Le-Bobby-Cow/MESA_Arduino_Project_-_Water_Tester/Documentation/Work-Progression Log.md

# Prototyping Log

Format :

## Prototype X
### Build Process
- Note any issues that arose during the build process

### Programming Process
- Note any issues or features that were added or resolved

### Prototype Performance Report
- Describe the performance and functionality
- Include Annotated Pictures

### Issues and Additions
- Note any issues that arose during testing
- Note future additions for the next prototype
