Le-Bobby-Cow/MESA_Arduino_Project_-_Water_Tester/Documentation/Design Brief.md

# Design Brief
Objective: The Design Brief provides a brief, non-technical overview of the entire project. The
design brief is a short document that can be used alone or as support during the presentations and
poster symposium to provide the reader with enough information about the project to:
- understand the target user and the challenges they face that inspired the project;
- state the project goals;
- provide a general idea of the prototype and its key features;
- relay the current status of the project;
- convey the expected impact for the user and how perceived inequities are relieved;
- reflect on the team’s experience implementing the Human Centered Design Process.

## Format: Teams must use the Design Brief Template (see Appendix).

Required Elements
1. Problem Statement: Describe the people who will benefit from the project and the challenges
they face. Discuss the issues of inequity that the project hopes to address. 100 word maximum
2. User Research: Discuss key information about the users gathered through your research,
interviews, and ongoing discussion with the user throughout the project. The information
shared here should be directly related to the user’s needs, insight, goals, and prototype. 200
word maximum
3. User Insight: Discuss your team’s understanding of the experiences, emotions, and motivations
of the users. This insight should inform the rest of the project and help the reader have a deeper
understanding of the inequity of the user. 200 word maximum
4. User Needs: Develop a specific list of the user’s needs produced from the user insight. The
needs should be reflected in the project goals. 100 word maximum
5. Project Goals: List project goals and describe how they are linked to and will adequately meet
the user’s needs and address inequities and/or barriers faced by the user. Meeting these goals
should be reflected in the key features and graphic(s) provided. 100 word maximum
6. Key Features of Design: List key features, illustrating that the design will adequately meet
project goals. 200 word maximum
7. Prototype Graphic: Include a graphic that is easy to understand with key features that are
adequately labeled. The reader should have a general understanding of how the prototype
functions by looking at the graphic.
8. Status of Project: Describe the current status of the project and discuss potential next steps. 200
word maximum
9. Impact: Discuss how design addresses inequities for the user and/or removes barriers. This
impact should reflect how the team met the project goals. 200 word maximum
10. Reflection: Show that the team has an increased understanding of human-centered design.
Examples of personal growth and insights gained about designing for others and helping them
overcome challenges should also be included. 200 word maximum
