Le-Bobby-Cow/MESA_Arduino_Project_-_Water_Tester/Design/Electrical Schematics/Prototype Schematic rev.2.png

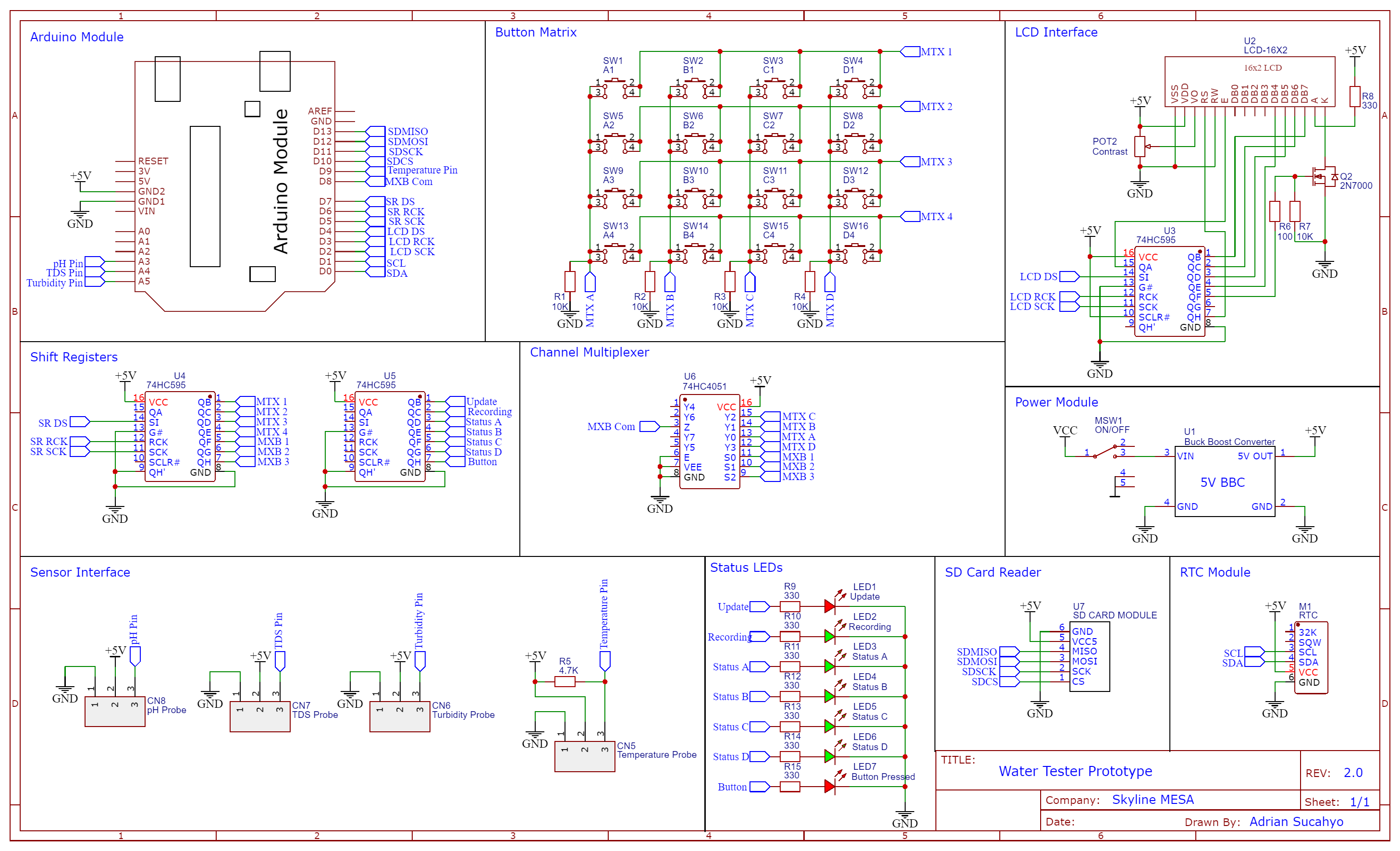
Design/Electrical Schematics/Prototype Schematic rev.2.png
