Le-Bobby-Cow/MESA_Arduino_Project_-_Water_Tester/Documentation/Finalized Documentation/Arduino MESA Water Filter Perspective.png

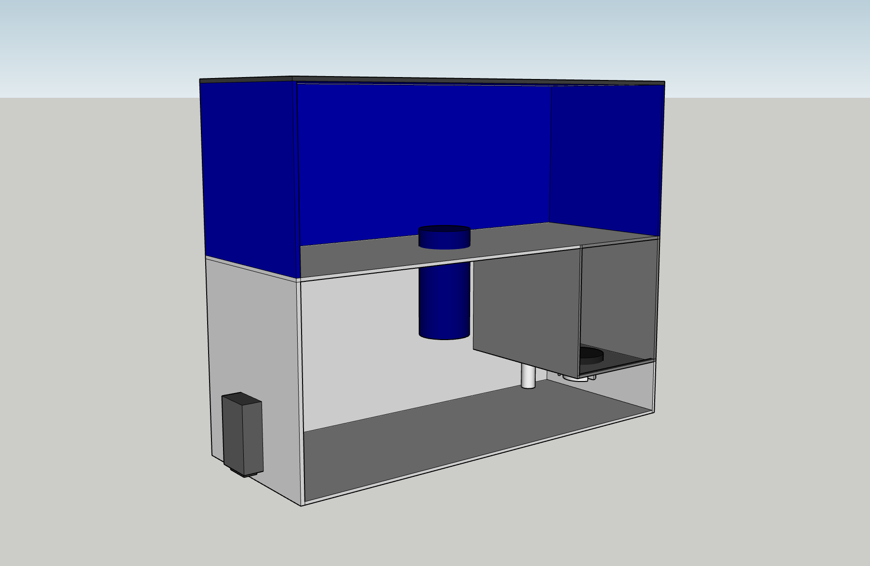
Documentation/Finalized Documentation/Arduino MESA Water Filter Perspective.png
