Le-Bobby-Cow/MESA_Arduino_Project_-_Water_Tester/Documentation/Finalized Documentation/Arduino MESA Water Filter Side.png

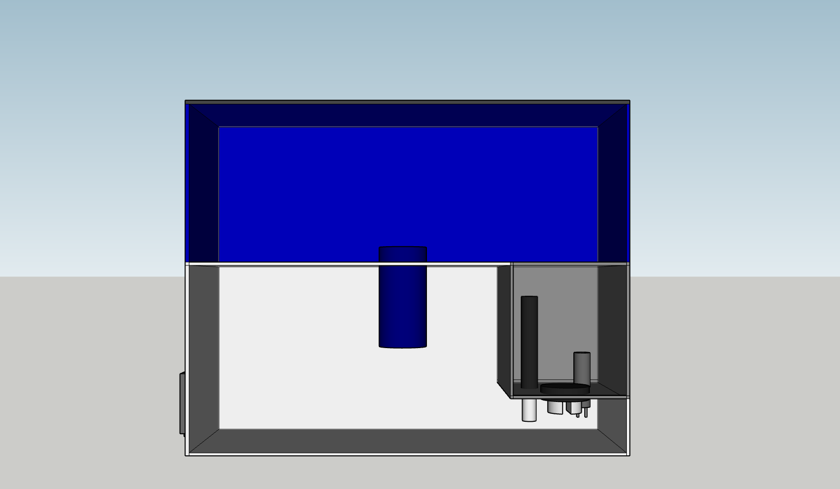
Documentation/Finalized Documentation/Arduino MESA Water Filter Side.png
