Le-Bobby-Cow/MESA_Arduino_Project_-_Water_Tester/MESA_Sterling_Scholar/MESA_Sterling_Scholar/data/blue-long-exposure-photo-of-body-of-water-lake-lake-image.jpeg

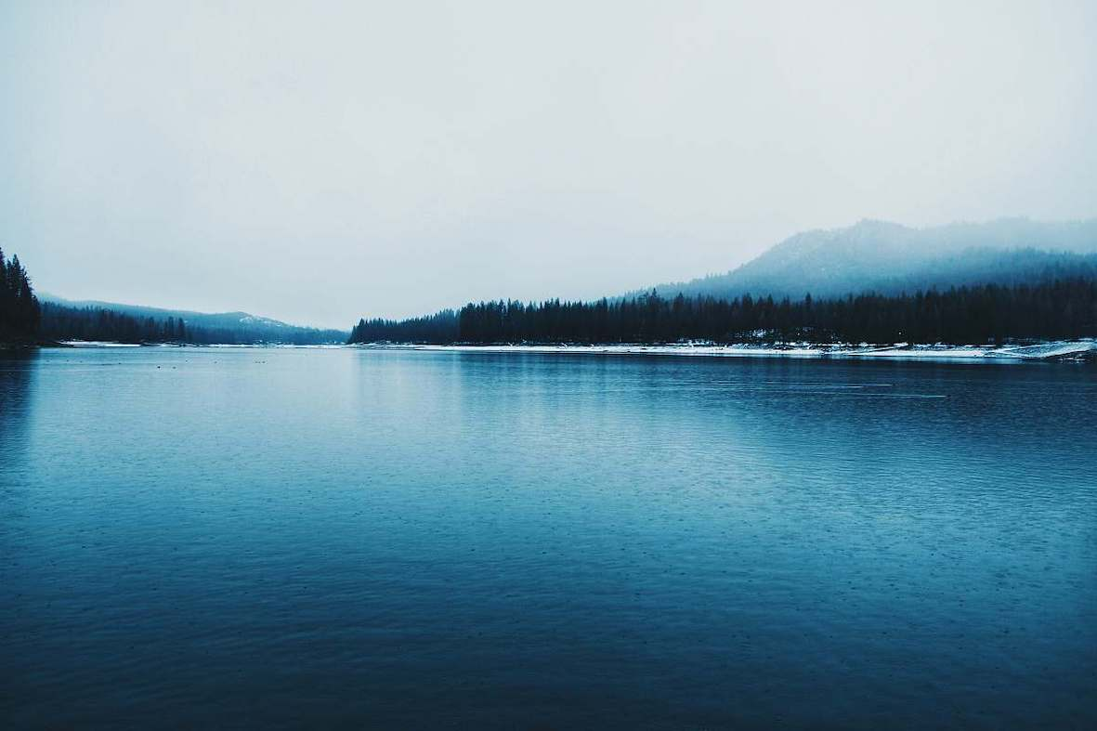
MESA_Sterling_Scholar/MESA_Sterling_Scholar/data/blue-long-exposure-photo-of-body-of-water-lake-lake-image.jpeg
