Le-Bobby-Cow/MESA_Arduino_Project_-_Water_Tester/Design/Wiring Diagrams/BOM rev.3.png

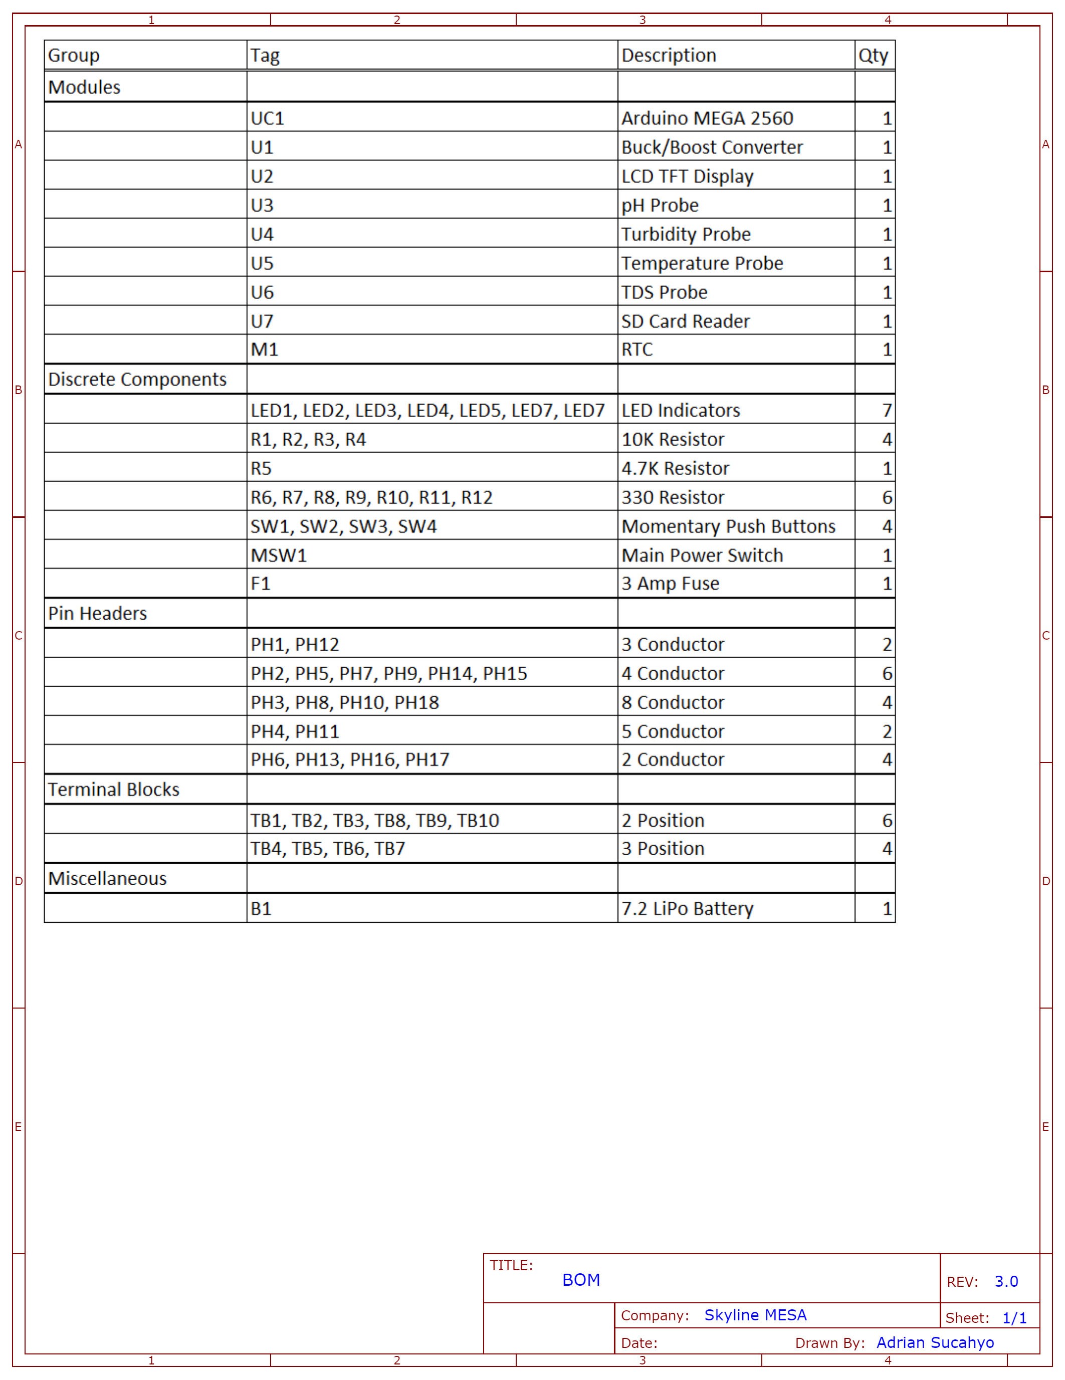
Design/Wiring Diagrams/BOM rev.3.png
