Le-Bobby-Cow/MESA_Arduino_Project_-_Water_Tester/Design/Wiring Diagrams/Cover Page rev.3.png

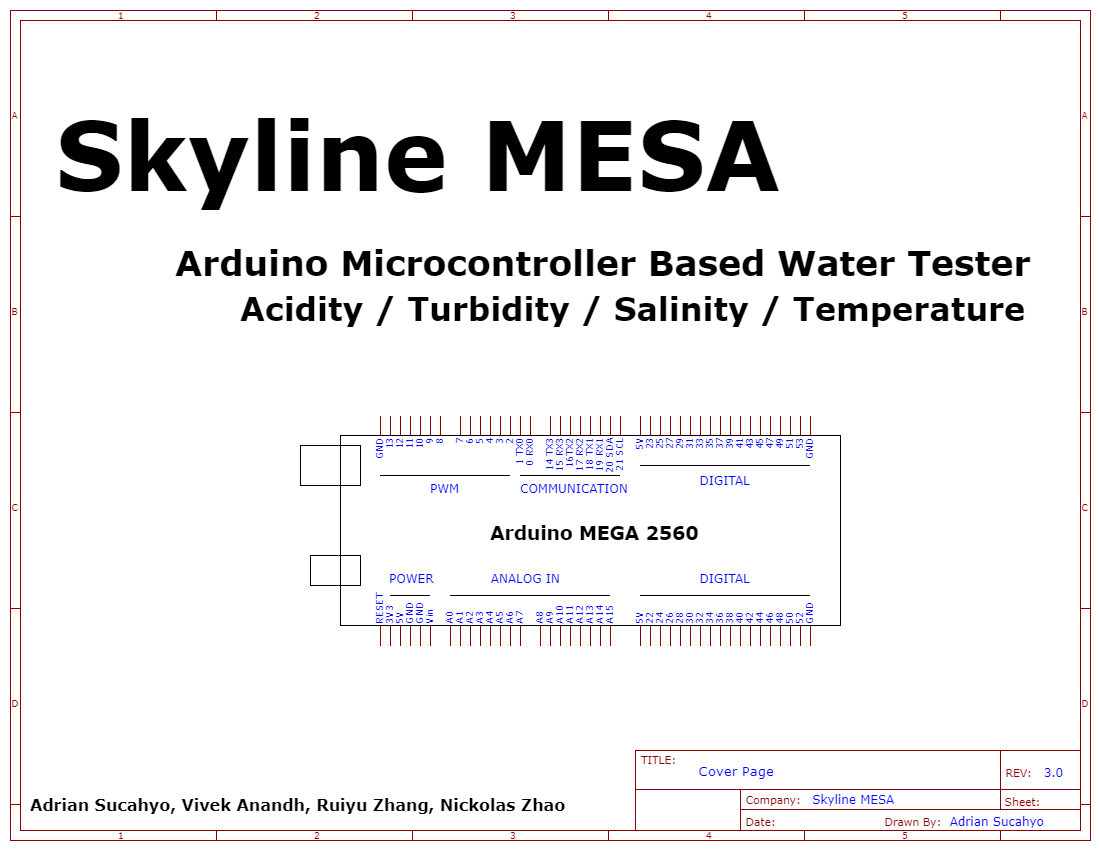
Design/Wiring Diagrams/Cover Page rev.3.png
