Le-Bobby-Cow/MESA_Arduino_Project_-_Water_Tester/Design/Wiring Diagrams/Wiring Design Reference rev.3.png

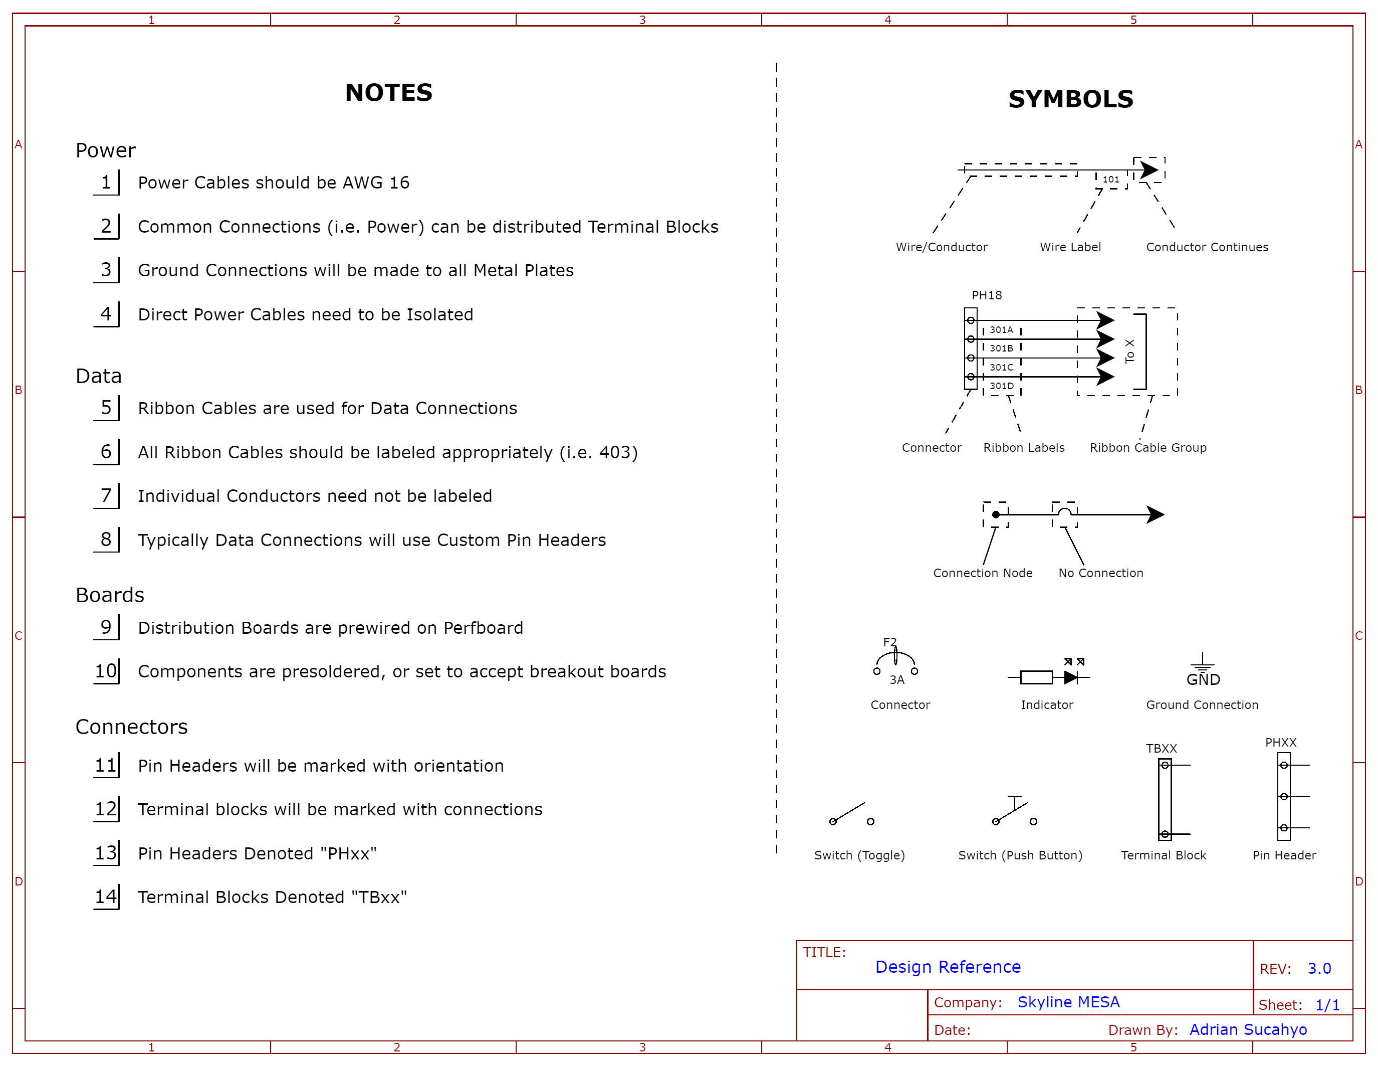
Design/Wiring Diagrams/Wiring Design Reference rev.3.png
