Le-Bobby-Cow/MESA_Arduino_Project_-_Water_Tester/Design/Block Diagrams/Water Tester Block Diagram rev.2.png

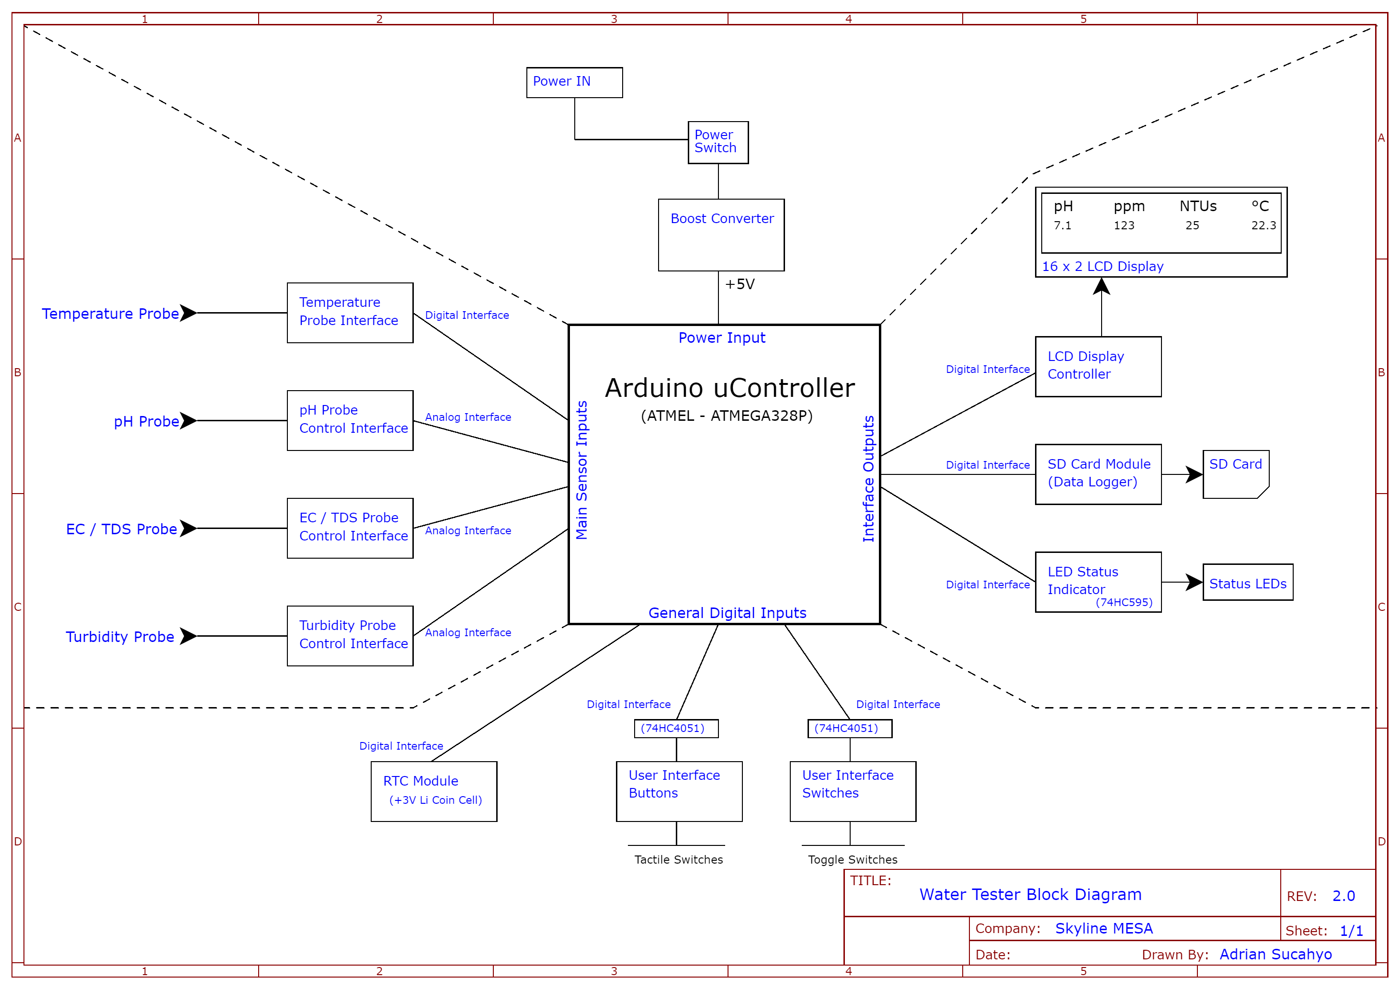
Design/Block Diagrams/Water Tester Block Diagram rev.2.png
