Le-Bobby-Cow/MESA_Arduino_Project_-_Water_Tester/Documentation/Finalized Documentation/MESA Water Tester (Filter).pdf

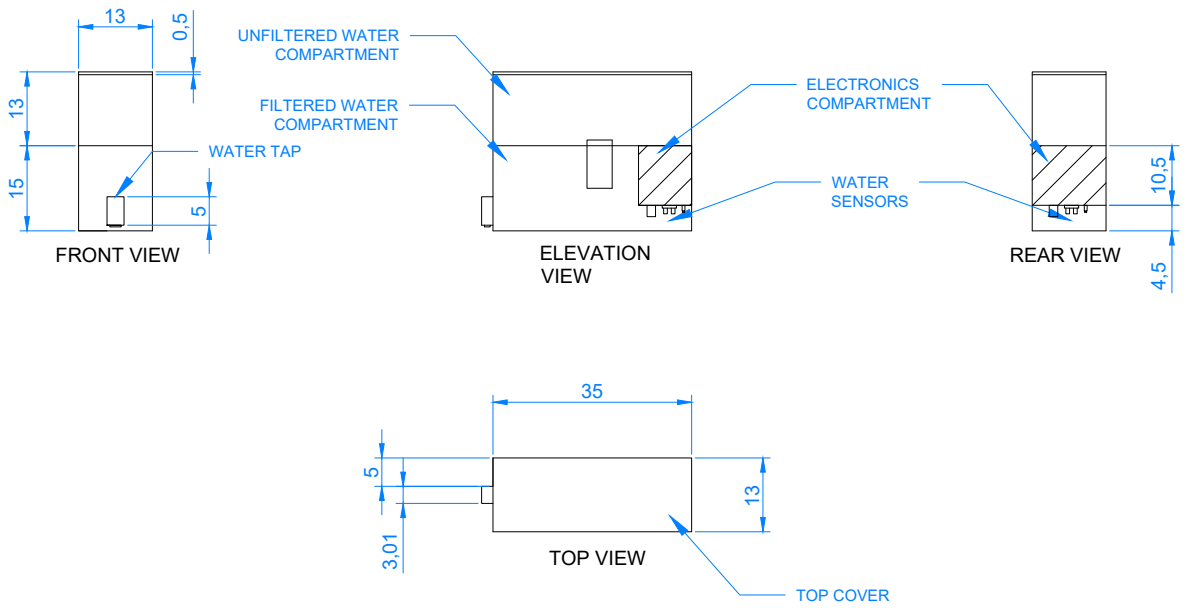
[picture p17: page 1]
TOP VIEW ELEVATION VIEW FRONT VIEW; REAR VIEW

3,01 5 WATER TAP ELECTRONICS COMPARTMENT TOP COVER WATER SENSORS UNFILTERED WATER COMPARTMENT FILTERED WATER COMPARTMENT
