Le-Bobby-Cow/MESA_Arduino_Project_-_Water_Tester/Design/Wiring Diagrams/All Wiring Diagrams rev.3.pdf

## Power Regulator

+5V

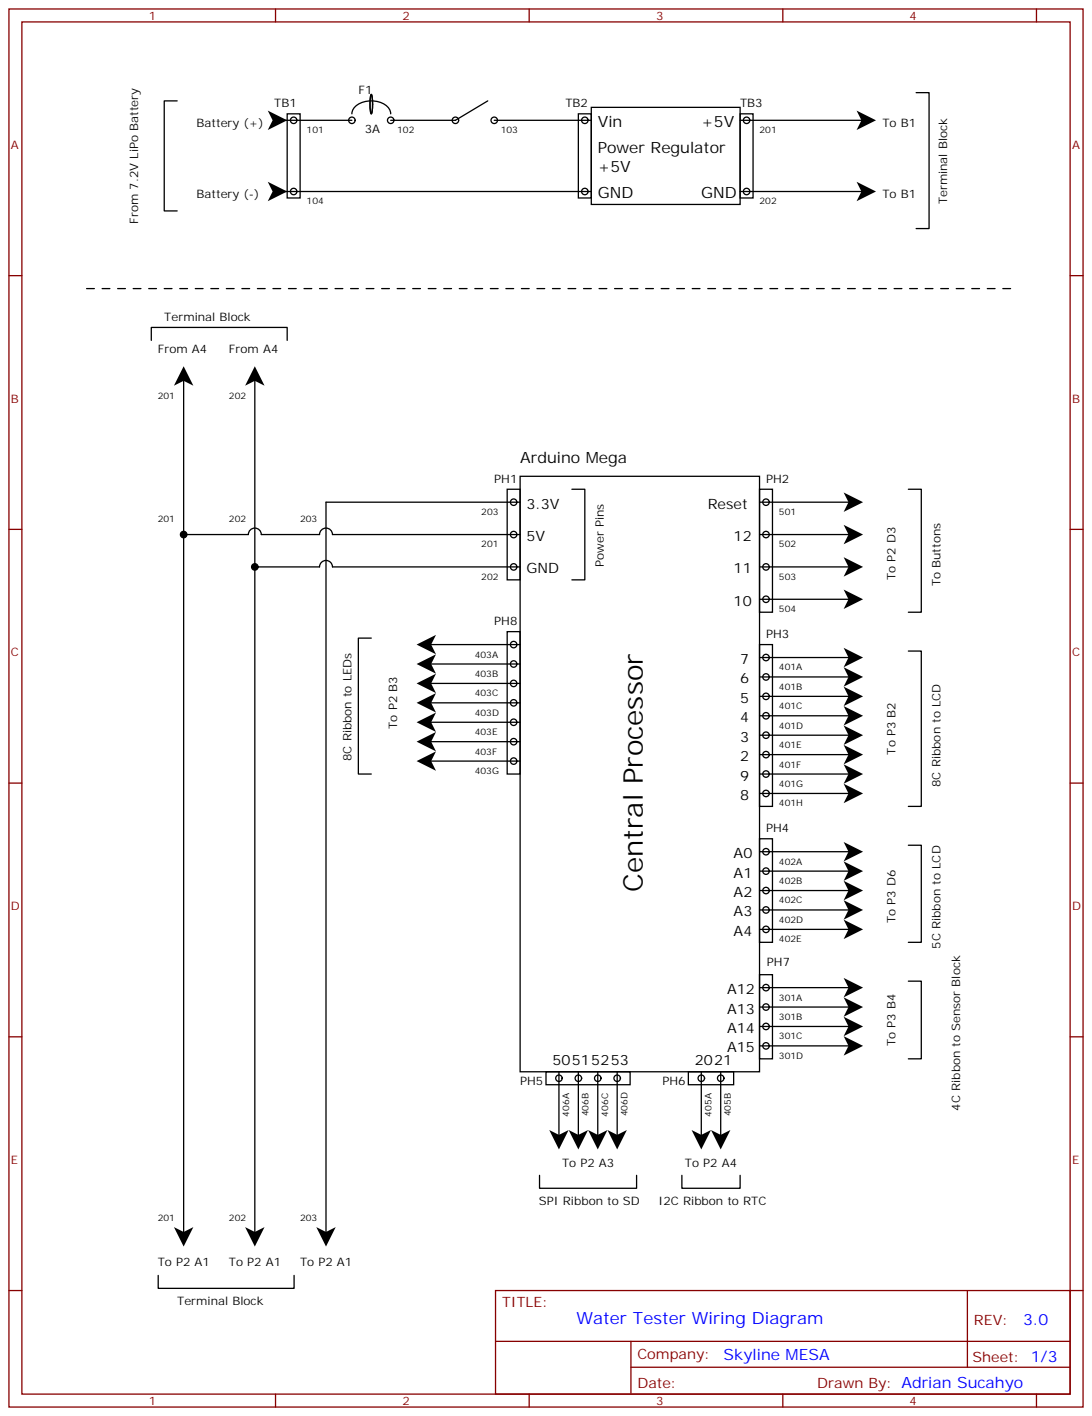
[picture p18: page 1]

8C Ribbon to LCD 5C Ribbon to LCD

4C Ribbon to Sensor Block

Drawn By: Adrian Sucahyo

## Power Regulator

+5V

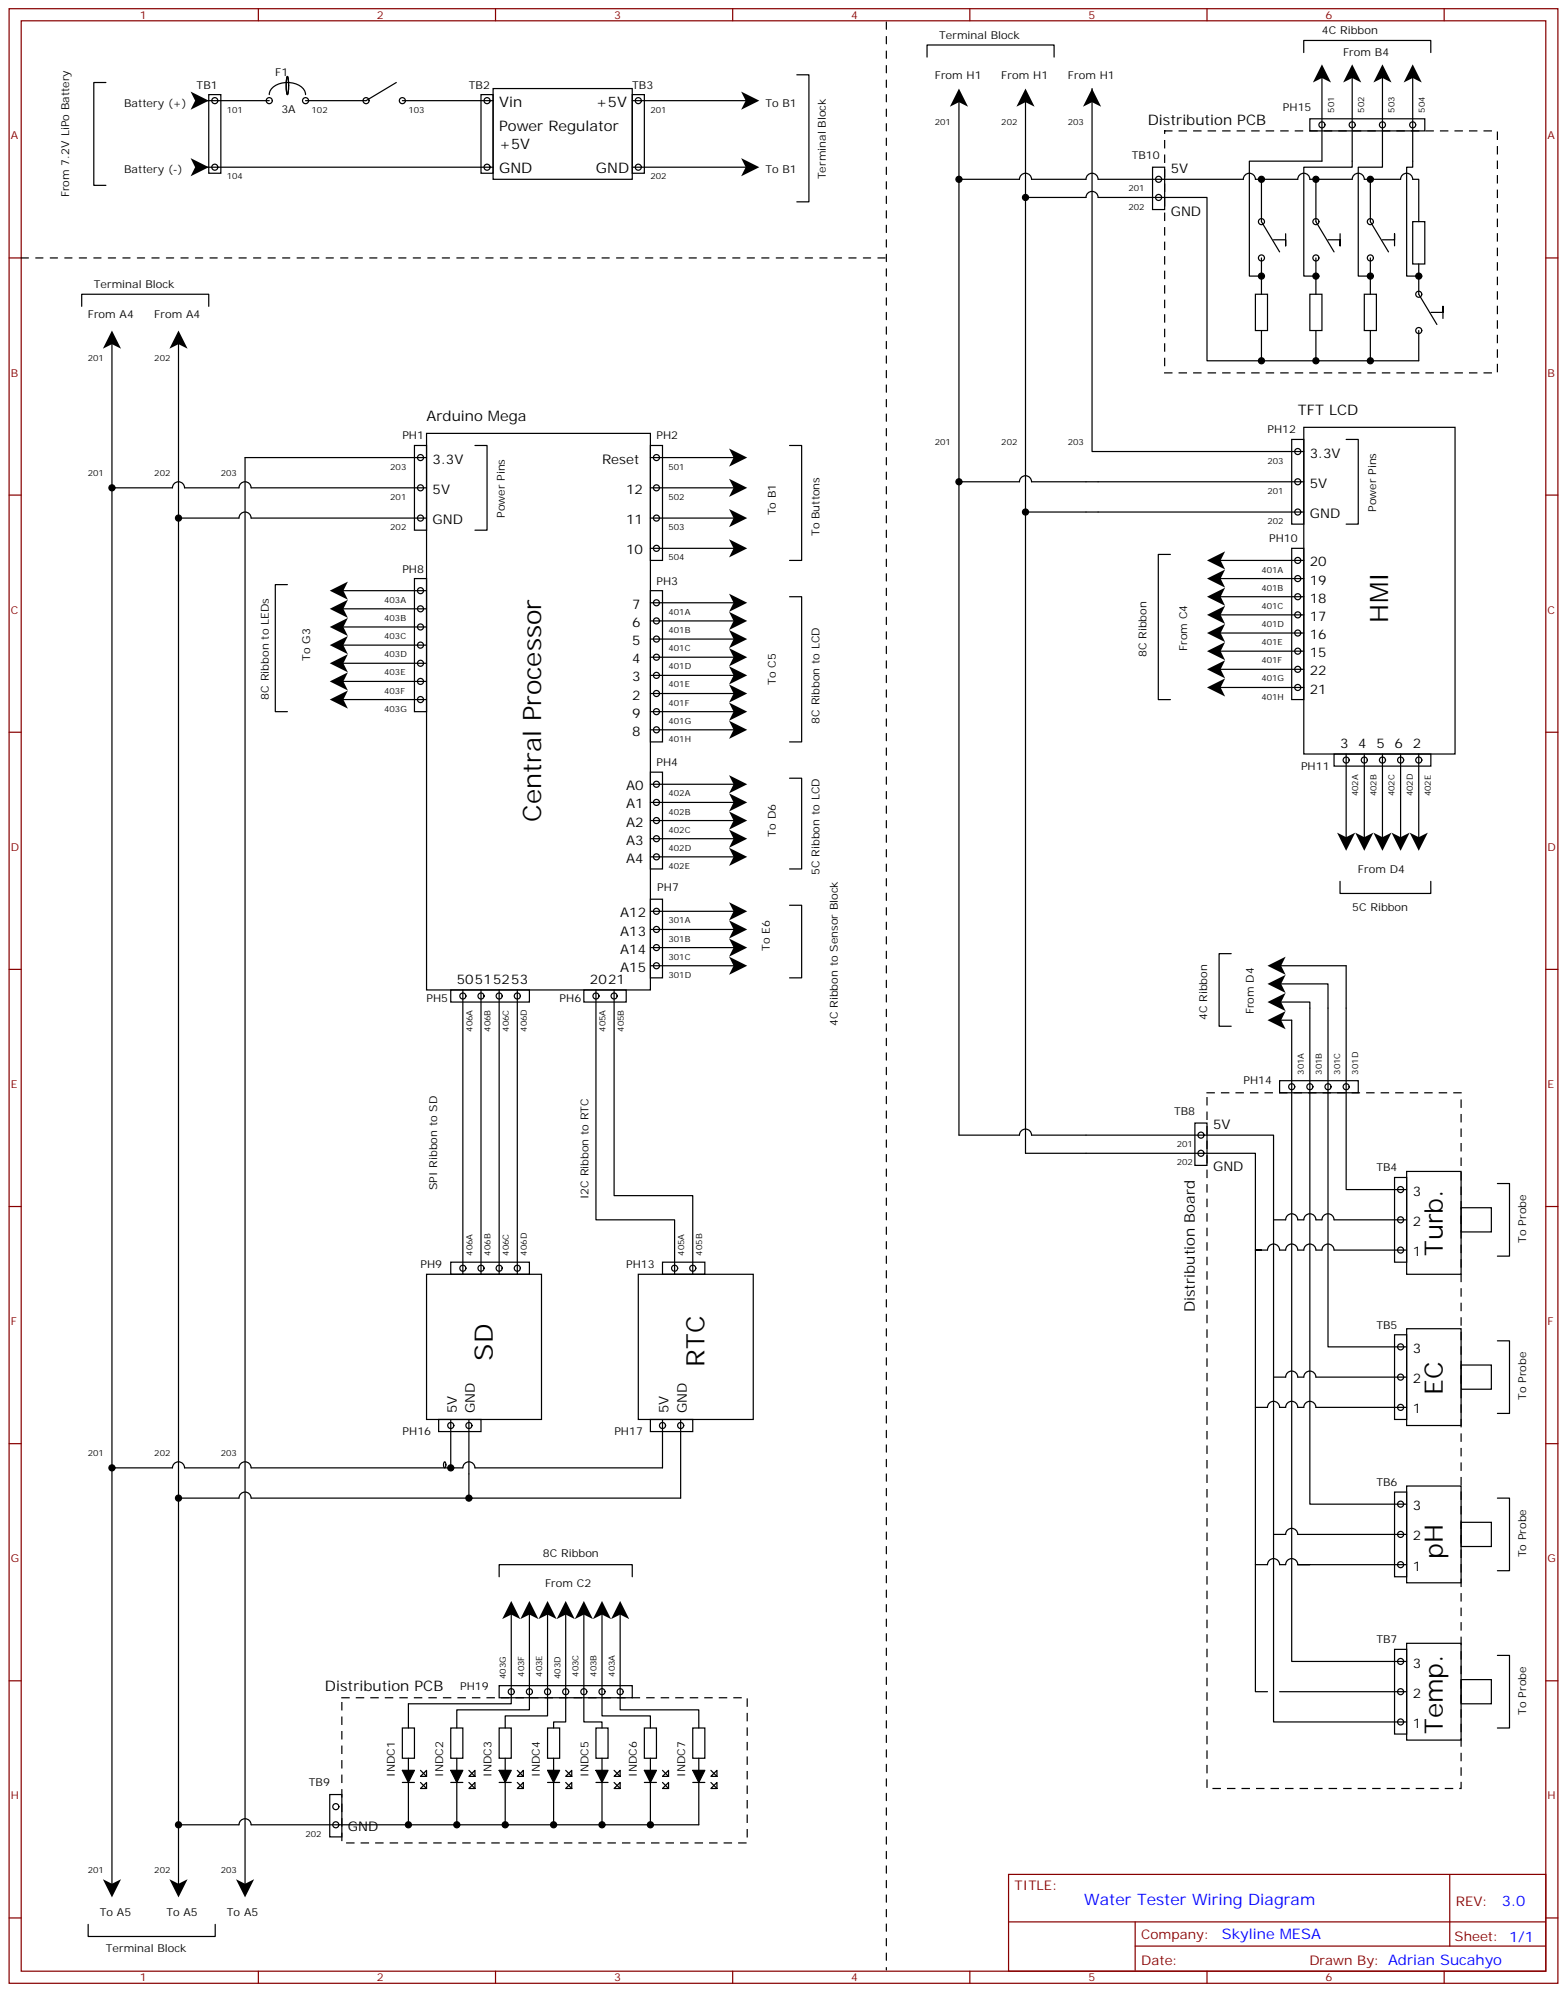
[picture p19: page 2]

8C Ribbon to LCD 5C Ribbon to LCD

4C Ribbon to Sensor Block

SPI Ribbon to SD

pH Temp. EC Turb.

To Probe To Probe

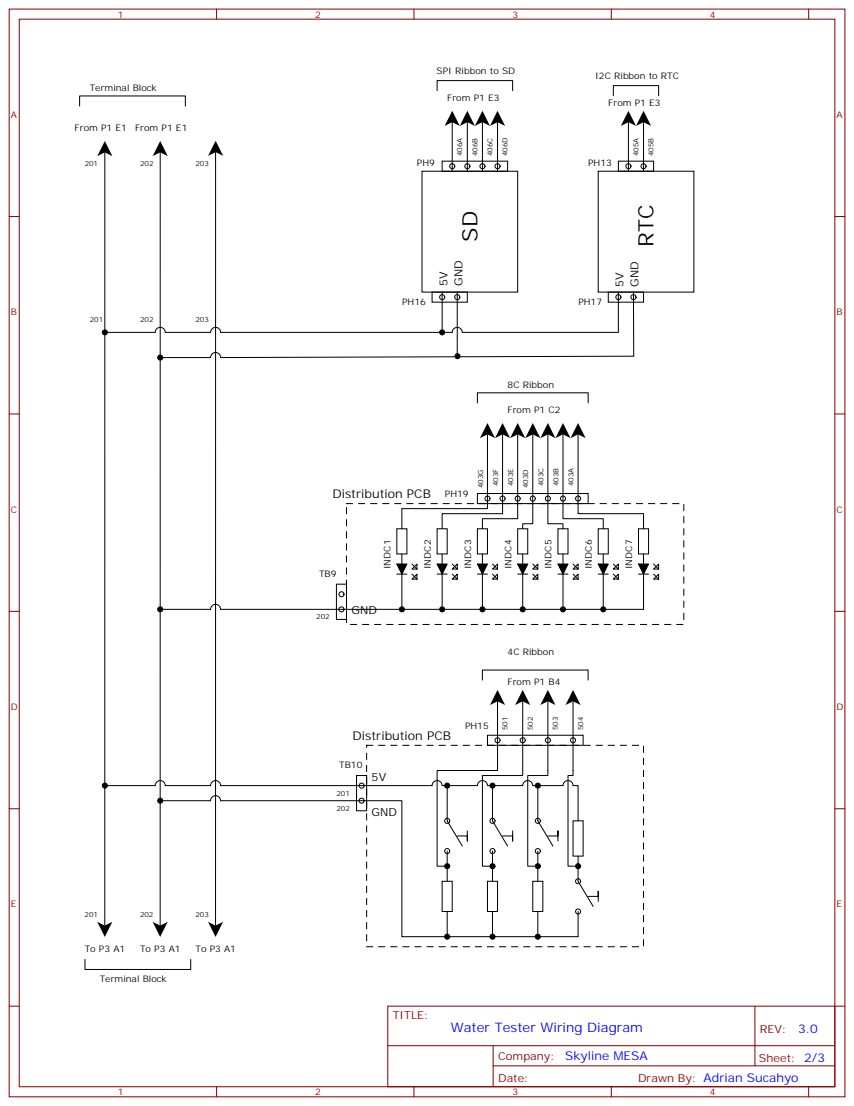
[picture p20: page 3]

I2C Ribbon to RTC SPI Ribbon to SD

## TFT LCD

# 4C Ribbon 301A

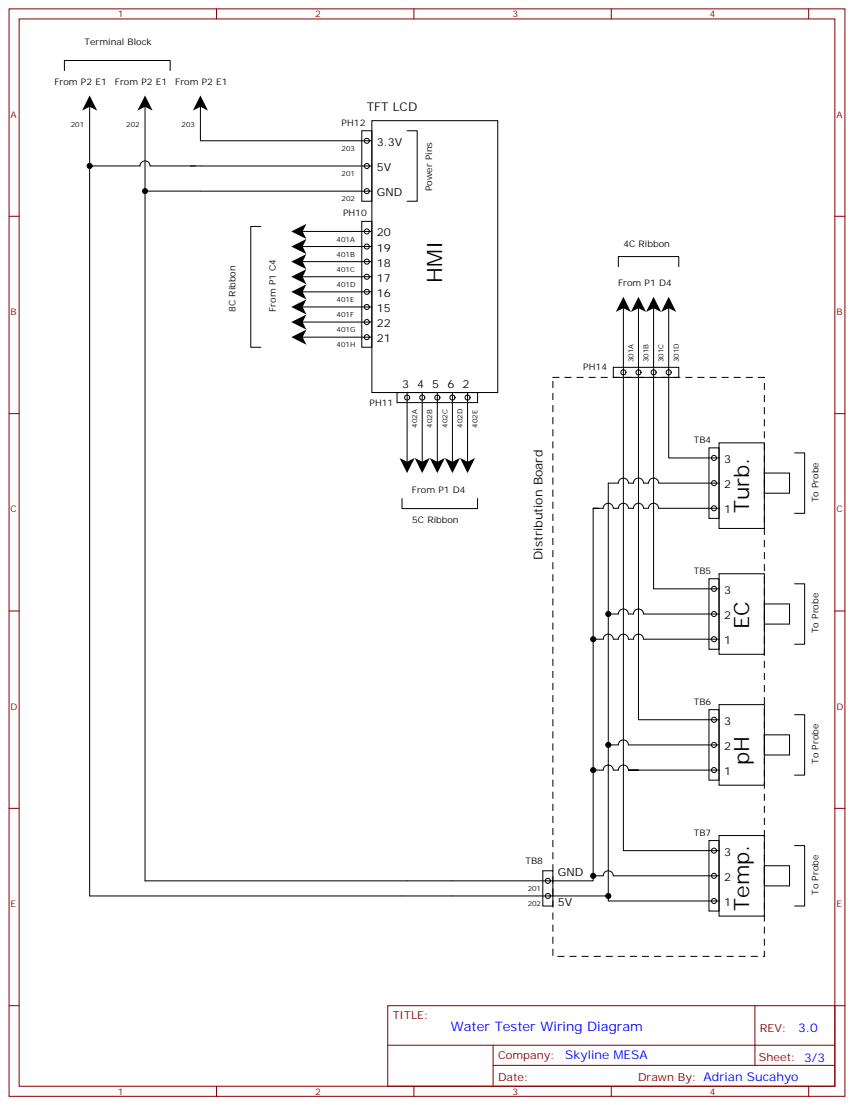
[picture p21: page 4]

pH Temp. EC Turb.

To Probe To Probe
