Le-Bobby-Cow/MESA_Arduino_Project_-_Water_Tester/Design/Wiring Diagrams/Wiring Diagram rev.3.pdf

A | A
B | B

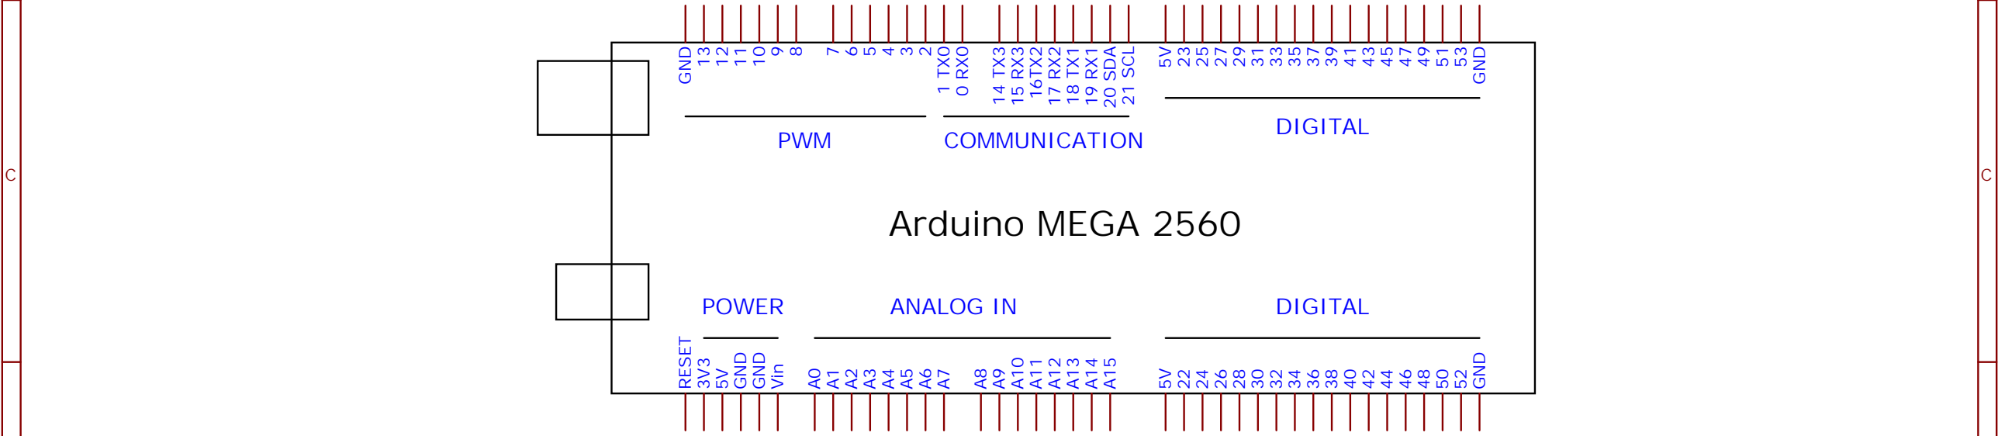
[picture p22: figure]
Arduino MEGA 2560; 53 GND; GND; 19 RX1 20 SDA 21 SCL; GND RESET; GND Vin; POWER; ANALOG IN; PWM; COMMUNICATION; DIGITAL

D | D

### TITLE:

Cover Page | REV: 3.0

### Date:

### Sheet:

## Drawn By: Adrian Sucahyo

## Company: Skyline MESA

# Skyline MESA

# Arduino Microcontroller Based Water Tester

# Acidity / Turbidity / Salinity / Temperature

# Adrian Sucahyo, Vivek Anandh, Ruiyu Zhang, Nickolas Zhao

## Power Cables should be AWG 16

## Common Connections (i.e. Power) can be distributed Terminal Blocks

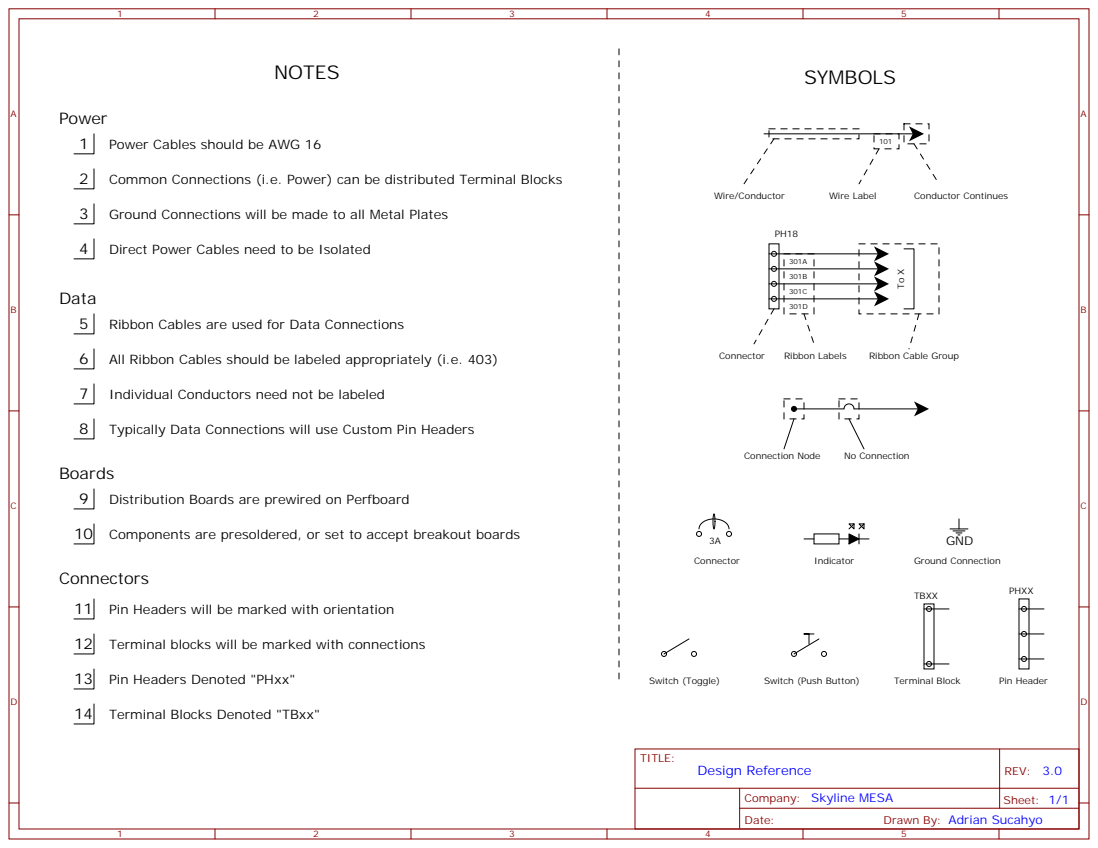
[picture p23: page 2]

3 Ground Connections will be made to all Metal Plates

4 Direct Power Cables need to be Isolated

Data
Ribbon Cables are used for Data Connections
All Ribbon Cables should be labeled appropriately (i.e. 403)
Individual Conductors need not be labeled

8 Typically Data Connections will use Custom Pin Headers

Boards
9 Distribution Boards are prewired on Perfboard

10 Components are presoldered, or set to accept breakout boards

11 Pin Headers will be marked with orientation

12 Terminal blocks will be marked with connections

13 Pin Headers Denoted "PHxx"

14 Terminal Blocks Denoted "TBxx"

## Power Regulator

+5V

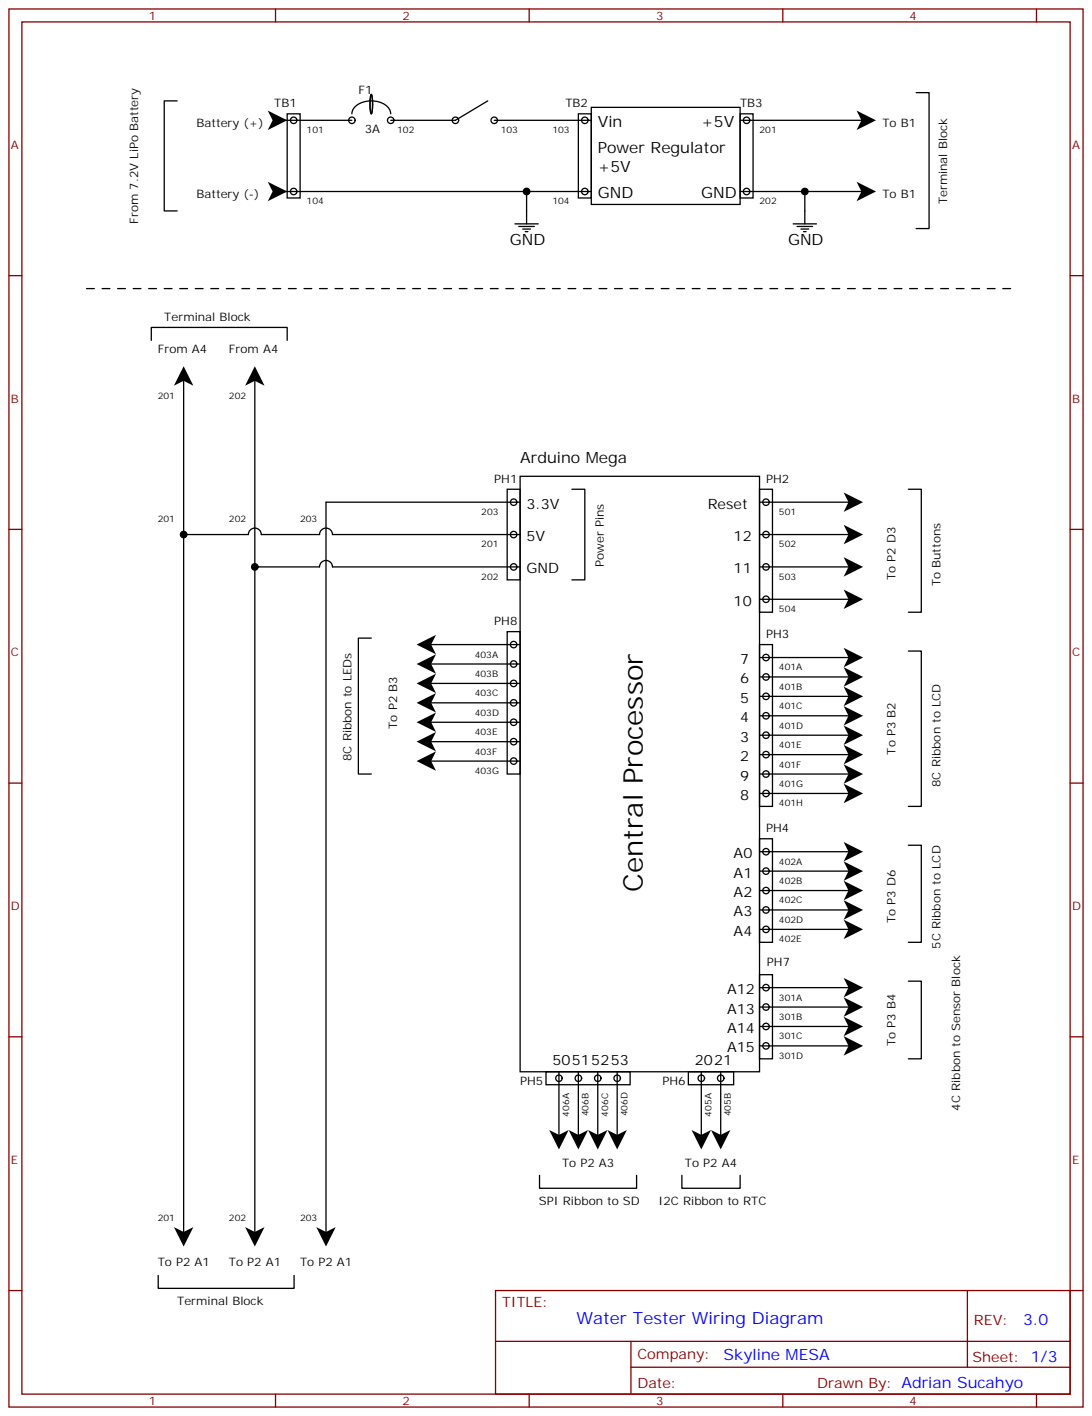
[picture p24: page 3]

8C Ribbon to LCD 5C Ribbon to LCD

4C Ribbon to Sensor Block

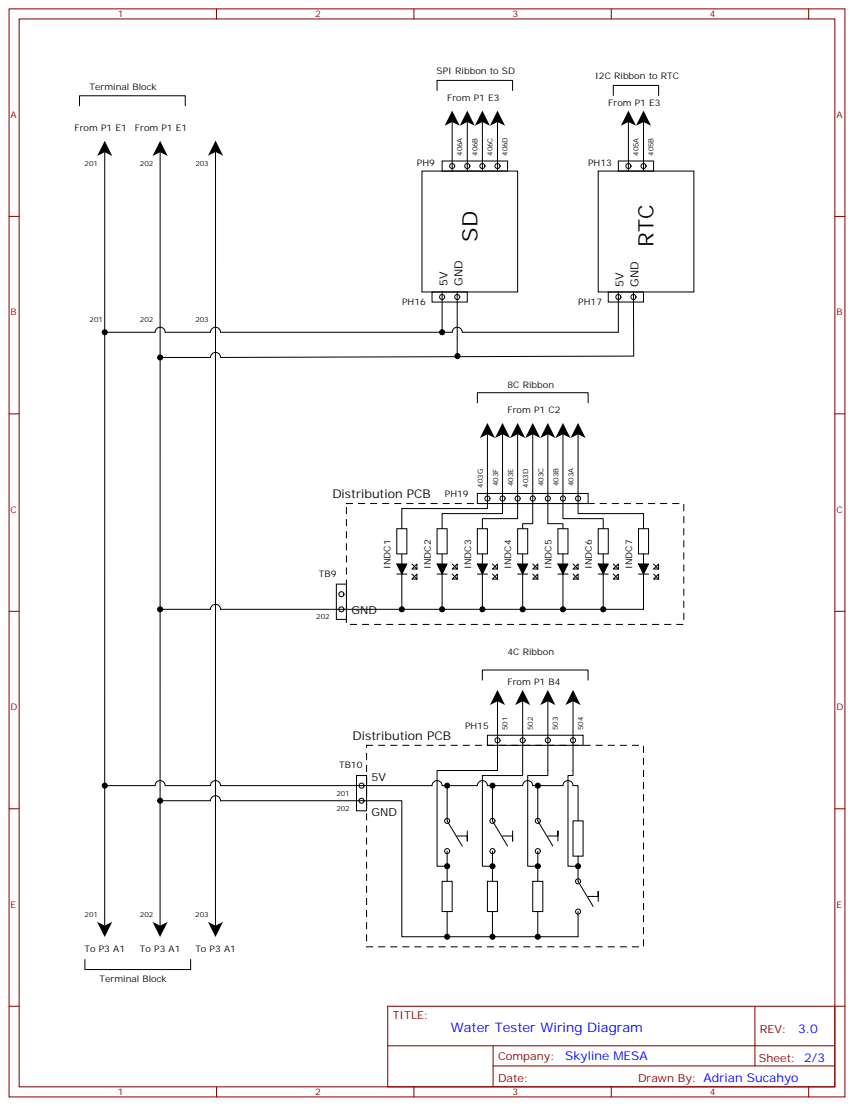
[picture p25: page 4]

I2C Ribbon to RTC SPI Ribbon to SD

## TFT LCD

# 4C Ribbon 301A


pH Temp. EC Turb.

To Probe To Probe

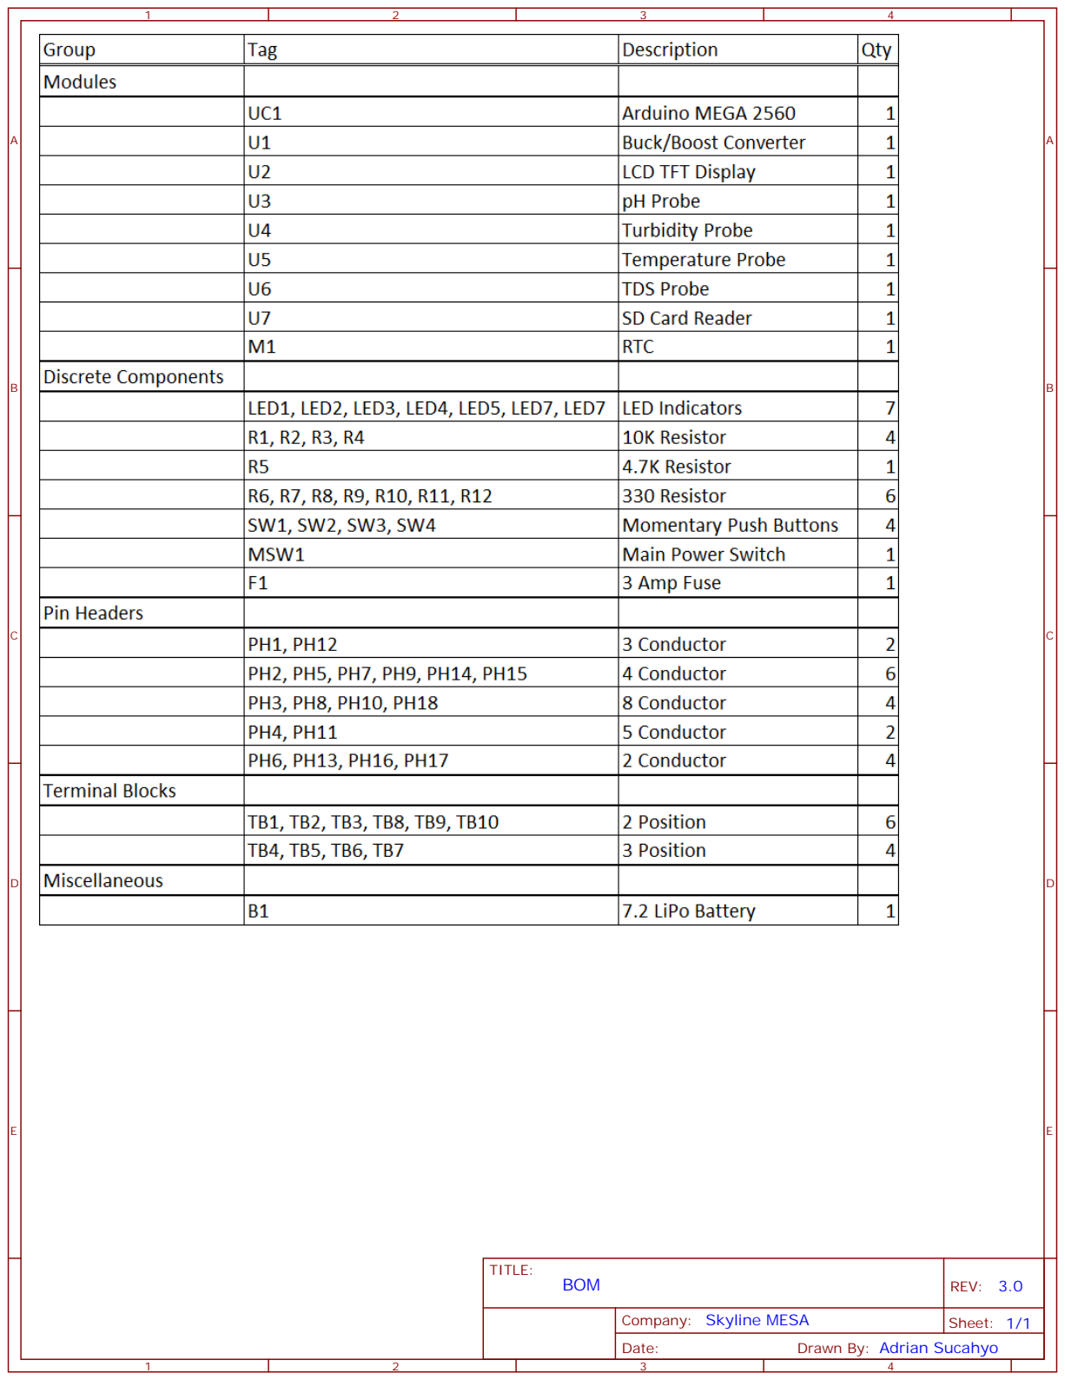
[picture p26: page 6]

A | A
B | B
C | C
D | D
E | E
BOM | REV: 3.0
