Le-Bobby-Cow/MESA_Arduino_Project_-_Water_Tester/Code/Arduino/Water__Monitor_Project/Turbidity_Sensor.h

/*-----------------------------------------------------------------------------------------
 * 
 * 
 * 
 * 
 ------------------------------------------------------------------------------------------*/

#define SensorPin A0

float voltage = 0;
float sensorValue = 0;

void setupTurb() {
}

float readTurbidity() {
  sensorValue = analogRead(SensorPin);
  return sensorValue;
}

float calculateTurbidity() {
  float NTU;
  voltage = readTurbidity() * (5.0/1024.0);
  NTU = (-1120.4 * (sq(voltage)))+ (5742.3 * voltage) - 4352.9;
  return NTU;
}
