Le-Bobby-Cow/MESA_Arduino_Project_-_Water_Tester/Code/Arduino/Simple/Simple.ino

#include <OneWire.h>
#include <DallasTemperature.h>

#define ONE_WIRE_BUS 8

OneWire oneWire(ONE_WIRE_BUS);

DallasTemperature sensors(&oneWire);

 float Celcius=0;
 float Fahrenheit=0;
void setup(void)
{
  
  Serial.begin(9600);
  sensors.begin();
}

void loop(void)
{ 
  sensors.requestTemperatures(); 
  Celcius=sensors.getTempCByIndex(0);
  Fahrenheit=sensors.toFahrenheit(Celcius);
  Serial.print(" C  ");
  Serial.print(Celcius);
  Serial.print(" F  ");
  Serial.println(Fahrenheit);
  delay(1000);
}
